Jorge-Mendes/Agro-Shield/Desenho_de_um_shield_Arduino_para_Agricultura_de_Precisao.pdf

PROJETO EM ENGENHARIA ELECTROTECNICA E DE ´ | COMPUTADORES | 14/07/2014

## Desenho de um shield Arduino para

## Agricultura de Precisão

### Jorge Miguel Ferreira da Silva Mendes

Abstract – The adoption of technologies in agriculture in order to monitor parameters that directly

or indirectly affect production has been an increasingly common practice. These technologies are

still expensive and complex. Creating an agronomic Arduino Shield might be a good alternative.

The device includes a set of interfaces which can be connected to multiple commercial sensors. This

article is a short introduction to precision agriculture and SDI-12 protocol and ends with the imple-

mentation results.

Resumo – Cada vez mais se tem vindo a adotar a utilização de tecnologias nos processos agrícolas

com o intuito de efetuar uma monitorização de parâmetros que os afetam direta ou indiretamente.

Essas tecnologias ainda são caras e complexas de operar. A criação de um Shield agronómico para

Arduino poderá ser uma boa alternativa. O dispositivo inclui um conjunto de interfaces onde po-

dem ser ligados vários sensores comerciais. O artigo faz uma pequena introdução à agricultura de

precisão, à norma SDI-12 e termina com os resultados depois da implementação prática.

Keywords – Agriculture Precision, Arduino, Shield

Palavras chave – Agricultura de Precisão, Arduino, Shield

c UTAD - ECT - Departamento de Engenharias

14/07/2014 | JORGE MIGUEL MENDES
I. INTRODUÇ AÕ

Na agricultura, os principais fatores que influenciam a produtividade de uma cul-
tura sao as condiç ˜ | oes clim ˜ | aticas e o solo. Isto leva a que atualmente se invista ´
cada vez mais na area da Agricultura de Precis ´ | ao (AP), para desta forma procurar ˜
melhorar a quantidade e qualidade da produçao com uma diminuiç ˜ | ao de custos, ˜
tanto economicos como ambientais. ´
O objetivo principal deste projeto e o desenvolvimento de um prot ´ | otipo pequeno, ´
compacto e de baixo custo que permita efetuar a mediçao da v ˜ | arios par ´ | ametros ˆ
para que desta forma, agricultores e produtores possam atuar de acordo com as necessidades requeridas para o cultivo.

II. AGRICULTURA DE PRECISAÕ

AP e uma pr ´ | atica agr ´ | ícola que envolve uma monitorizaçao de todo o ciclo pro- ˜
dutivo. Esta tecnica parte da premissa de que cada ponto de amostra ´ | é unico, ou ´
seja, permite gerir diferenciadamente areas com carater ´ | ísticas distintas, em vez de
as considerar como um todo. (Coelho and Silva, 2009)

Existem varios fatores que podem ser medidos, de entre os quais se destacam os ´ seguintes: Humidade relativa; Temperatura do ar e do solo; Teor de agua no solo; ´
Radiaçao solar e ultravioleta; Di ˜ | ametro de caules, troncos e frutos; Velocidade e ˆ
direçao do vento; Pluviosidade; Press ˜ | ao atmosf ˜ | erica; Humidade foliar. (Libelium) ´
A. Tecnologias de eletrónica e de computação

As ferramentas que possibilitaram o aparecimento e desenvolvimento desta
pratica foram, em grande parte a eletr ´ | | onica (microcontroladores, sensores, ´
telecomunicaçoes, etc.) e outros dispositivos como o GPS ˜
| | 1 e o SIG² , que acoplados
as m ` | aquinas agr ´ | ícolas, permitem efetuar um levantamento de dados. (AP)

1Sistemas de Posicionamento Global.
2Sistema de Informaçao Geogr ˜ | afica. ´

III. SENSORES UTILIZADOS

Com base numa pesquisa a alguns sensores disponíveis comercialmente e usados
no contexto da AP foi possível constatar que os mesmo nao t ˜ | em uma interface ˆ
uniforme, podem apresentar uma saída em tensao, corrente, frequ ˜ | encia ou utilizar ˆ
protocolos sobre uma comunicaçao digital, de onde se destacam as normas RS485, ˜ I

2C, SDI-12, entre outras menos utilizadas.

IV. A NORMA SDI-12

SDI-12 e uma norma para interface entre gravadores de dados e sensores (liga- ´ dos a um barramento comum) baseados em microprocessadores. Funciona com
uma interface serie/digital com uma velocidade de transmiss ´ | ao de 1200 bit/s. ˜
De seguida faz-se uma breve descriçao da sua interface el ˜ | etrica e protocolo de ´
comunicaçao. (Rente et al., 2013) ˜
A. Interface elétrica

A norma SDI-12 usa um barramento para transmitir informaçao entre o sistema de ˜ processamento e armazenamento de dados (gravador) e os sensores a ele ligados.

O barramento SDI-12, e constitu ´ | ído por tres linhas: ˆ
- Linha de dados;
- Linha de referencia, ou terra;
- Linha de alimentaçao (+12V). ˜

A figura 1 mostra o barramento SDI-12, que liga dois sensores a um gravador de dados.

c UTAD - ECT - Departamento de Engenharias

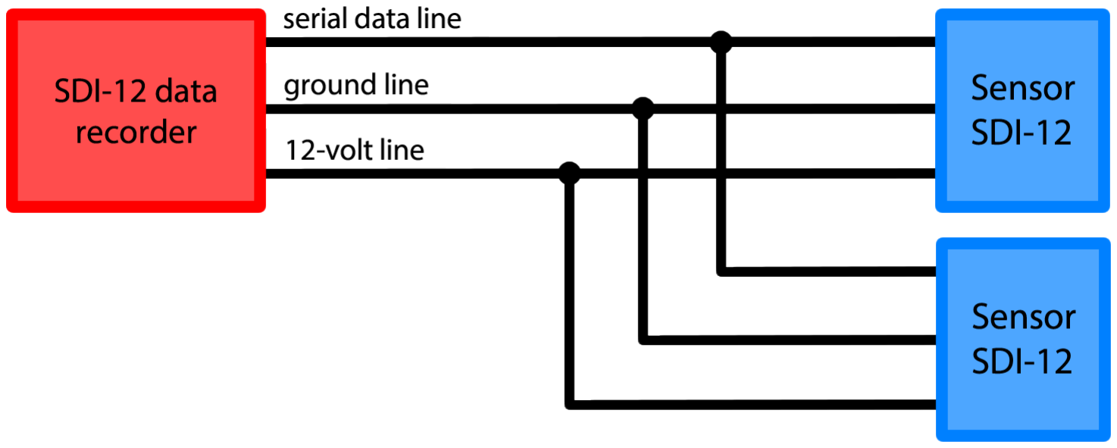
[picture p1: figure]

Figura 1
ILUSTRAÇ AO DE UM SISTEMA ˜ | SDI-12 BASICO ´ | .
B. Protocolo de Comunicação

O gravador de dados e os sensores SDI-12 comunicam entre si atraves da troca de ´ caracteres ASCII pela linha de dados. (SDI-12, 2013)

A comunicaçao entre o gravador e um sensor ˜ | e efetuada da seguinte forma: ´

Passo 1: O gravador de dados “acorda” com uma pausa (spacing contínuo na linha de dados durante, pelo menos, 12 ms) todos os sensores ligados ao barramento SDI-12;
Passo 2: O gravador envia um comando para um sensor específico, cujo endereço
e o primeiro caracter do comando, instruindo-o a fazer uma mediç ´ | ao; ˜
Passo 3: Esse mesmo sensor responde dentro de 15 ms retornando o tempo
maximo at ´ | e que os dados de mediç ´ | ao estejam prontos e o n ˜ | umero de valo- ´
res de dados que vai retornar;
Passo 4: Se a mediçao est ˜ | a imediatamente dispon ´ | ível, o gravador transmite um
comando de instruçao para que o sensor envie a resposta e, at ˜ | e a receber, o ´
gravador nao comunica com qualquer outro sensor. Se a mediç ˜ | ao n ˜ | ao estiver ˜
pronta, o gravador de dados espera que o sensor envie um pedido para o gravador, indicando que os dados estao prontos e de seguida o gravador, ˜ transmite um comando para obter os dados;
Passo 5: O sensor responde, devolvendo uma ou mais mediçoes. ˜

C. Comandos e respostas SDI-12

A tabela I apresenta um conjunto de comandos e respostas SDI-12 mais utilizados.

Nome | Comando | Resposta
Acknowledge Active | a! | a<CR><LF>
Send Identification | aI! | allccccccccmmmmmmvvvxxx...xx<CR><LF>
Change Address | aAb! | b<CR><LF>
Address Query | ?! | a<CR><LF>
Start Measurement | aM! | atttn<CR><LF>
Send Data | aD0! ... aD9! | a<values><CR><LF>

Tabela I

CONJUNTO DE COMANDO E RESPOSTAS SDI-12.

V. PROTOTIPO DE UM SISTEMA DE INTERFACE BASEADO EM ´ | ARDUINO
A. Hardware
As mediçoes de alguns par ˜ | ametros atrav ˆ | es de sensores adequados podem ser fa- ´
cilmente efetuadas com o auxilio da plataforma Arduino.

No decorrer deste projeto desenvolveu-se um dispositivo que possibilita a
monitorizaçao na ˜ | area da agricultura, compat ´ | ível com uma vasta gama de senso-
res. Trata-se de um Shield para Arduino, e tem como principal funçao o processa- ˜
mento e apresentaçao da informaç ˜ | ao relativa aos sensores, e fornecer as diferentes ˜
interfaces necessarias que permitam a ligaç ´ | ao simult ˜ | anea de v ˆ | arios sensores. ´

De seguida surgiu a ideia da criaçao de um segundo dispositivo que funcionaria ˜ de forma semelhante a um sensor SDI-12, ou seja, um dispositivo no qual seja possível da mesma forma a ligaçao de v ˜ arios sensores, e no qual este iria respon- ´ der ao Shield como se tratasse de um sensor SDI-12, figura 2. Isto tem como principal vantagem o facto de termos a possibilidade de criar o nosso proprio sensor ´
SDI-12 que permita medir varios par ´ | ametros. ˆ

c UTAD - ECT - Departamento de Engenharias

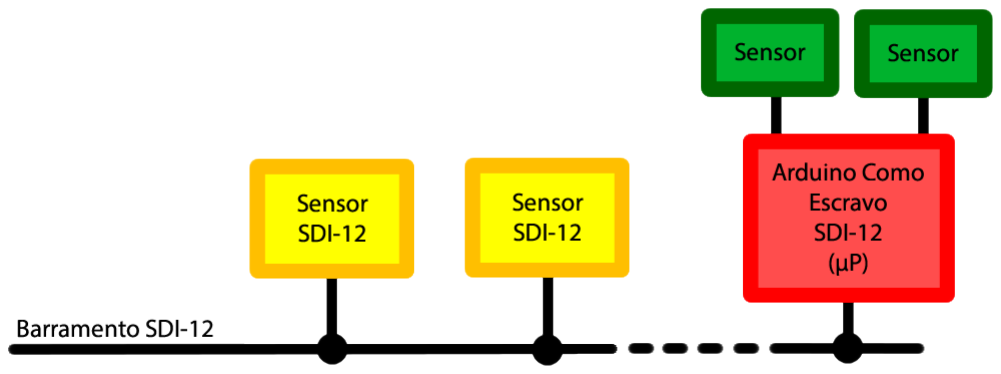
[picture p2: figure]

Figura 2

ARDUINO COMO ESCRAVO SDI-12.

Nas figura 3 e apresentado um esquema el ´ | etrico do ´ | Shield e nas figuras 4 e 5, é
apresentada uma simulaçao 3D, gerada com os softwares Eagle 3D e POV-Ray. ˜

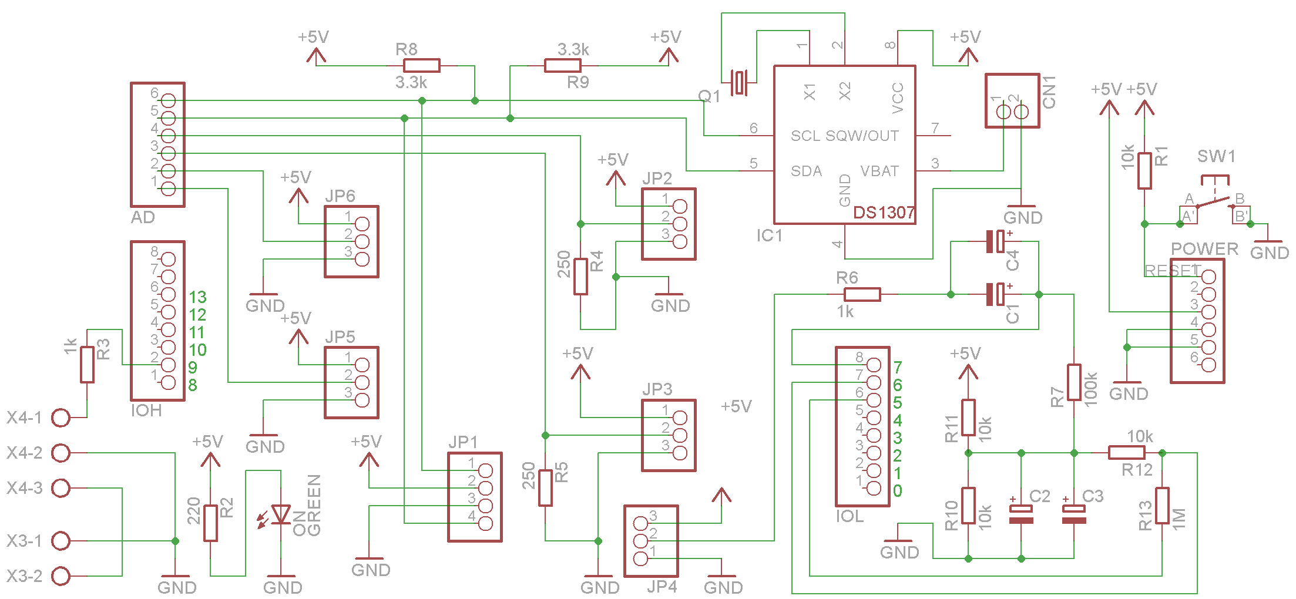
[picture p3: figure]

Figura 3
ESQUEMA ELETRICO DO ´ | Shield.
B. Interface de E/S
As mediçoes s ˜ | ao fornecidas por v ˜ | arios sensores que s ´ | ao ligados ao dispositivo por ˜
meio de varias interfaces. ´
Na figura 6 e mostrado o diagrama de blocos do ´ | | | Shield. A interface SDI-12 e uma ´
das mais importantes interfaces padrao na ˜ | area da AP, pois proporciona grande ´
flexibilidade uma vez que possui uma ampla variedade de sensores compatíveis

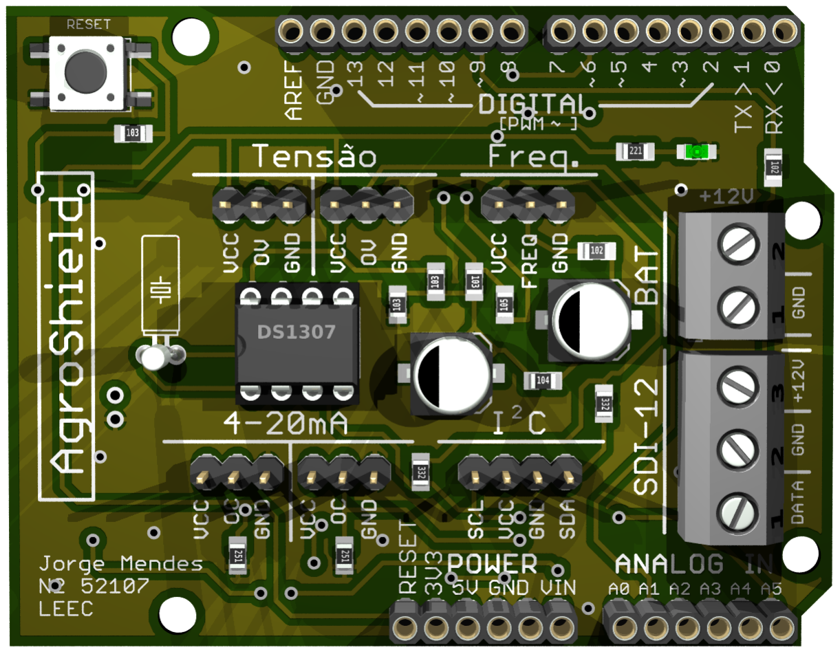
[picture p4: figure]

Figura 4

PARTE FRONTAL DO Shield.

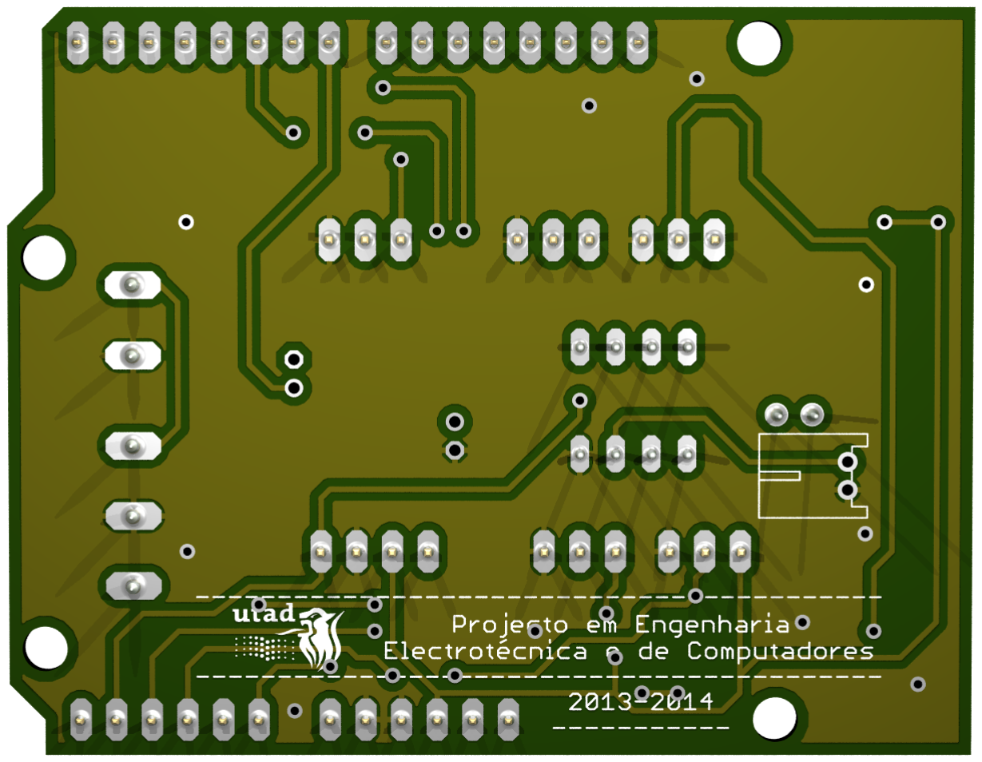
[picture p5: figure]

Figura 5

PARTE TRASEIRA DO Shield.

no mercado. De acordo com as características tecnicas do protocolo SDI-12, os sen- ´ sores necessitam de uma alimentaçao de +12V e, uma vez que o Arduino apenas ˜ fornece no maximo 5V, houve a necessidade de colocar um conector para uma ba- ´
teria externa exclusivamente para a alimentaçao dos sensores SDI-12. Foi tamb ˜ | em´
colocado um RTC que utiliza o protocolo de comunicaçao I ˜ | 2C para desta forma ser
possível identificar as mediçoes com base na data e hora a que foram efetuadas. ˜

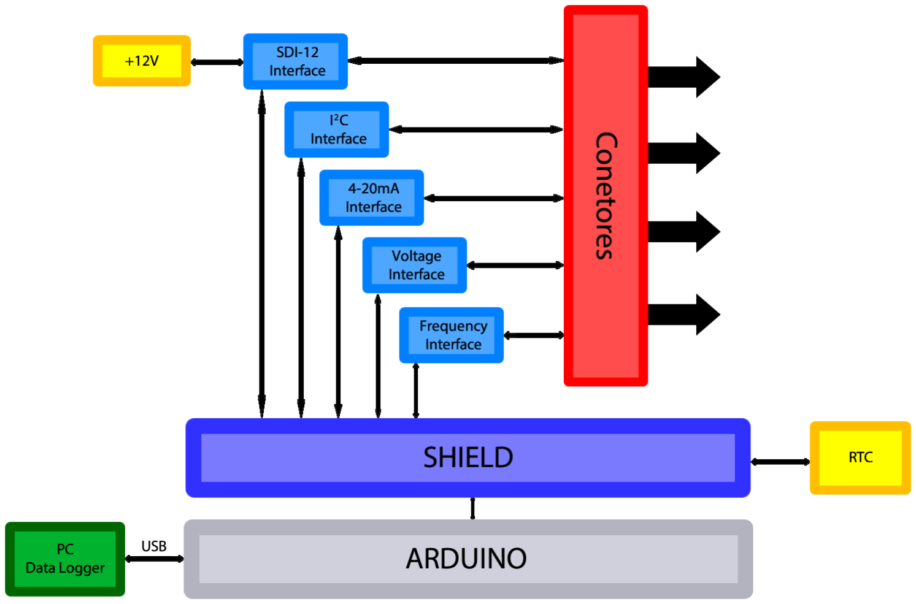
[picture p6: figure]

Figura 6

INTERFACES PERMITIDAS PELO Shield PROPOSTO.

c UTAD - ECT - Departamento de Engenharias

O Shield conta ainda com as seguintes interfaces:

Interface 4-20mA: A interface 4-20mA e uma das interfaces mais utilizadas na ´
instrumentaçao industrial e na ˜ | area da agricultura. ´
Interface em tensão: Esta interface e muito comum, principalmente em sensores de ´ baixo custo e devido tambem´ a sua facilidade de uso quando utilizados com ´ microcontroladores.
Interface em frequência: Interface tambem bastante comum, utilizada maioritaria- ´ mente em pluviometros e anemometros. ´
C. Software
Para facilitar ainda mais o trabalho de quem futuramente ira utilizar este ´ | Shi-
eld foi desenvolvida uma biblioteca, disponível em https://github.com/
Jorge-Mendes/Agro-Shield, (https://github.com/Jorge-Mendes/Agro-Shield) onde vem ja implementadas algumas funç ´ | oes ˜
de leitura dos sensores. Essas funçoes s ˜ | ao apresentadas na tabela II. ˜
Funçaõ | Descriçaõ
readSensor(uint8 t sensor) | Permite efetuar a leitura dos sensores com saída em tensaõ em corrente e em frequencia, utilizando como par ˆ ametros de ˆ entrada “SENS VOLTAGE 1/2”, “SENS CURRENT 1/2” ou “SENS FREQUENCY” respetivamente.
readSensor(uint8 t sensor, int address, int num bytes) | Permite efetuar a leitura do sensores que utilizam o protocolo de 2C e aceita como parametros de entrada a indicaç ˆ ao de que ˜ comunicaçao I ˜ a leitura efetuada e do tipo I ´ 2C (“SENS I2C”), o endereço do sensor e o numero de bytes que vao ser retornados. ˜
SDI12(uint8 t mode) | Permite efetuar a leitura dos sensores SDI-12 e aceita como parametro ˆ de entrada varios modos de funcionamento, tais como “CHECK ´ ALL”, “WILD CARD”, “SIMPLE LOGGER” e “INTERFACE”.
getDateTime() | Permite obter a data e hora atual do RTC.
setDateTime() | Define a data e hora do RTC para a data e hora de compilaçao do ˜ programa.

Tabela II
ALGUMAS FUNÇ OES IMPLEMENTADAS NA BIBLIOTECA ˜ | .

A biblioteca inclui ainda um Sketch exemplo que efetua a leitura de todos os sensores cujo diagrama de fluxo e apresentado na figura 7. ´

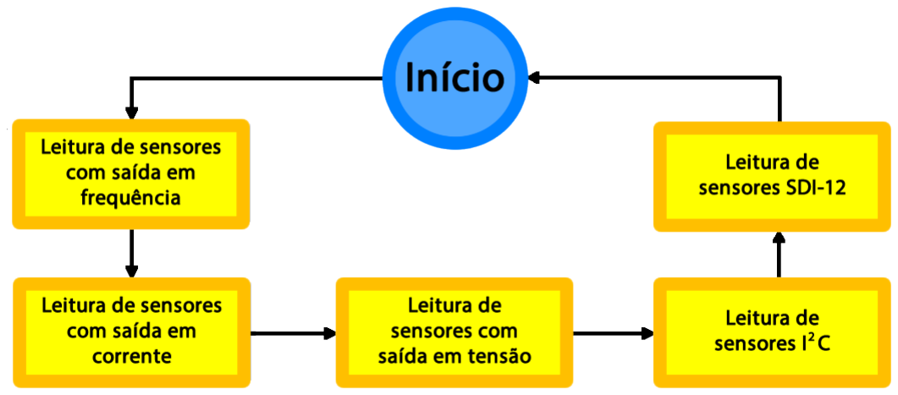
[picture p7: figure]

Figura 7

DIAGRAMA DE FLUXO DO Sketch EXEMPLO.

D. Aplicação e resultados experimentais

Nos testes do Shield foi utilizado um sensor de temperatura com saída em tensao, ˜ um gerador de sinais para produzir um sinal com uma determinada frequencia, ˆ um sensor I²C e o Arduino que funcionava como um sensor SDI-12. Foi utilizado o IDE do Arduino para visualizar as mediçoes dos sensores e efetuar o envio ˜
dos comandos no caso da interface SDI-12. Em seguida sao apresentadas v ˜ | arias ´
imagens resultantes dos testes e respetiva descriçao. (Tekbox) ˜
O teste ilustrado na figura 8 consistiu na utilizaçao das funç ˜ | oes getDateTime() ˜
para obter a data e hora a que as mediçoes foram efectuadas, readSensor(uint8 ˜ | t
sensor) para obter as mediçoes dos sensores com sa ˜ | ída em frequencia, corrente ˆ
e tensao e readSensor(uint8 ˜ | t sensor, int address, int num bytes) para obter as
mediçoes dos sensores I ˜

2C.

No teste da figura 9 foi utilizada a funçao SDI12(uint8 ˜ | t mode) no modo
“WILD CARD”, funçao esta que retorna os endereços dos sensores SDI-12 liga- ˜ dos. Retornou os sensores de “a” a “h”, uma vez que o Arduino que se encontrava a funcionar como sensor SDI-12 estava a simular estes 8 sensores.

c UTAD - ECT - Departamento de Engenharias

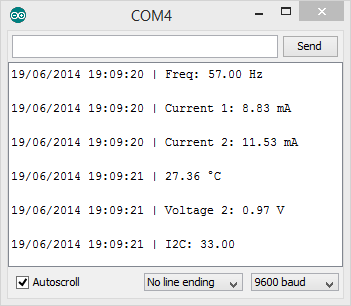
[picture p8: figure]

Figura 8

EXEMPLO DE LEITURA DE SENSORES.

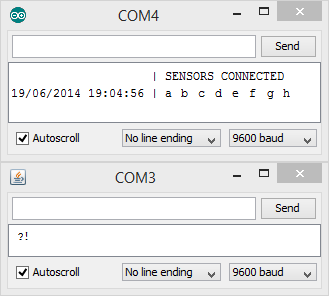
[picture p9: figure]

Figura 9

MAPA DOS SENSORES SDI-12 LIGADOS AO Shield.

Para o teste da figura 10 foi utilizada a funçao SDI12(uint8 ˜ | t mode) no modo
“SIMPLE LOGGER” que retorna a informaçao e as mediç ˜ | oes efetuadas por to- ˜
dos os sensores ligados. Como se pode ver no Serial Monitor do lado direito

(correspondente ao Arduino que se encontra a funcionar como um sensor SDI-12), recebe os comandos (pedidos) e envia a respetiva resposta. Existe tambem o ´ modo “CHECK ALL” que funciona de forma semelhante, mas retorna apenas as informaçoes dos sensores. ˜

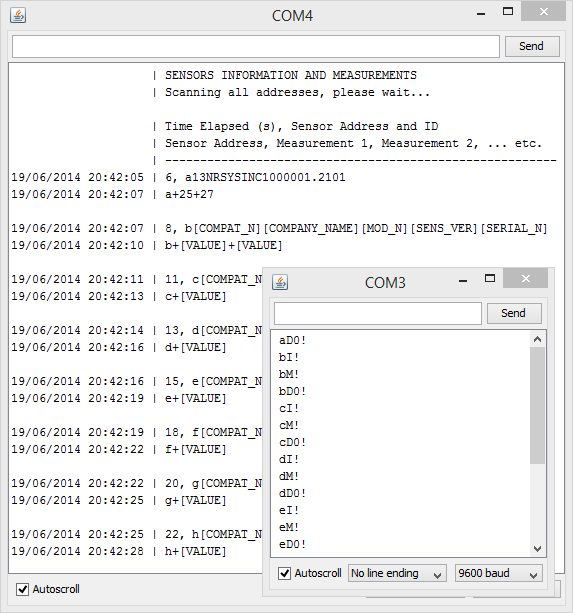
[picture p10: figure]

Figura 10

EXEMPLO DE UM data logger SIMPLES.

No ultimo teste, figura 11, foi utilizada a funç ´ | ao SDI12(uint8 ˜ | t mode) no modo
“INTERFACE” que permite ao utilizador enviar um comando para o sensor e, desta forma, obter a resposta desejada.

c UTAD - ECT - Departamento de Engenharias

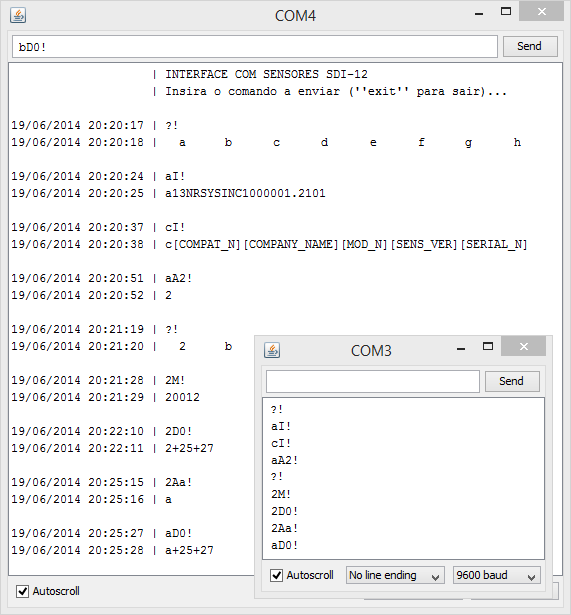
[picture p11: figure]

Figura 11

INTERFACE COM OS SENSORES SDI-12.

VI. CONCLUSOES ˜

Neste projeto foi desenvolvido um Shield com a finalidade de efetuar uma
monitorizaçao de v ˜ | arios par ´ | ametros no ramo da agricultura. Tal como era pre- ˆ
tendido, a partir deste artigo pode-se constatar que se trata de um dispositivo
simples, bastante economico (em comparaç ´ | ao com os dispositivos dispon ˜ | íveis no
mercado) e que possui varias interfaces a partir das quais os par ´ | ametros podem ˆ
ser medidos. A criaçao da biblioteca de funç ˜ | oes veio facilitar ainda mais o trabalho ˜
dos utilizadores, pois com um simples Sketch e poss ´ | ível efetuar a leitura das varias ´

interfaces como se pode ver a partir dos resultados experimentais. Futuramente
e pretendido dar continuidade ao trabalho j ´ | a desenvolvido, poder-se- ´ | a alargar o ´
numero de interfaces do ´ | Shield, aumentar o numero de funç ´ | oes da biblioteca, de- ˜
senvolver uma interface grafica com mais com mais funcionalidades e estender ´ o Shield a outras plataformas, para desta forma dar ainda mais versatilidade ao dispositivo para o seu uso numa ampla variedade de cenarios. ´

BIBLIOGRAFIA

AP. O que e agricultura de precis ´ | ao? Consultado em Abril de 2014, dispon ˜ | ível on-

line em http://www.macroprograma1.cnptia.embrapa.br/redeap2/

o-que-e-agricultura-de-precisao. (http://www.macroprograma1.cnptia.embrapa.br/redeap2/o-que-e-agricultura-de-precisao)
Coelho, J. and Silva, J. (2009). Modulo Microcontrolado de Interface padr ´ | | ao SDI-12 ˜
para aplicaçoes em monitoramento ambiental. pages 2–12. ˜
Libelium. New waspmote sensor board enables extreme precision agriculture in vineyards and greenhouses. Consultado em Maio de 2014, disponível online

em http://www.libelium.com/101651651444/.
Rente, B., Santos, G., Russano, P., Cernicchiaro, G., and Benevento, A. (2013).
Modulo Microcontrolado de Interface padr ´ | ao SDI-12 para aplicaç ˜ | oes em mo- ˜
nitoramento ambiental. pages 7–10.
SDI-12 (2013). SDI-12 - A Serial-Digital Interface Standard for Microprocessor-Based sensors.
Tekbox. SDI-12/USB Converter manual. pages 12–19.

c UTAD - ECT - Departamento de Engenharias
