Jorge-Mendes/Agro-Shield/(commit log)

2014-06-28 Wire examples
2014-06-28 Wire utility
2014-06-28 Wire library
